alow2004/Archimedes_RPI_DoublePort_RAM_Podule/Board_Picture1.jpg

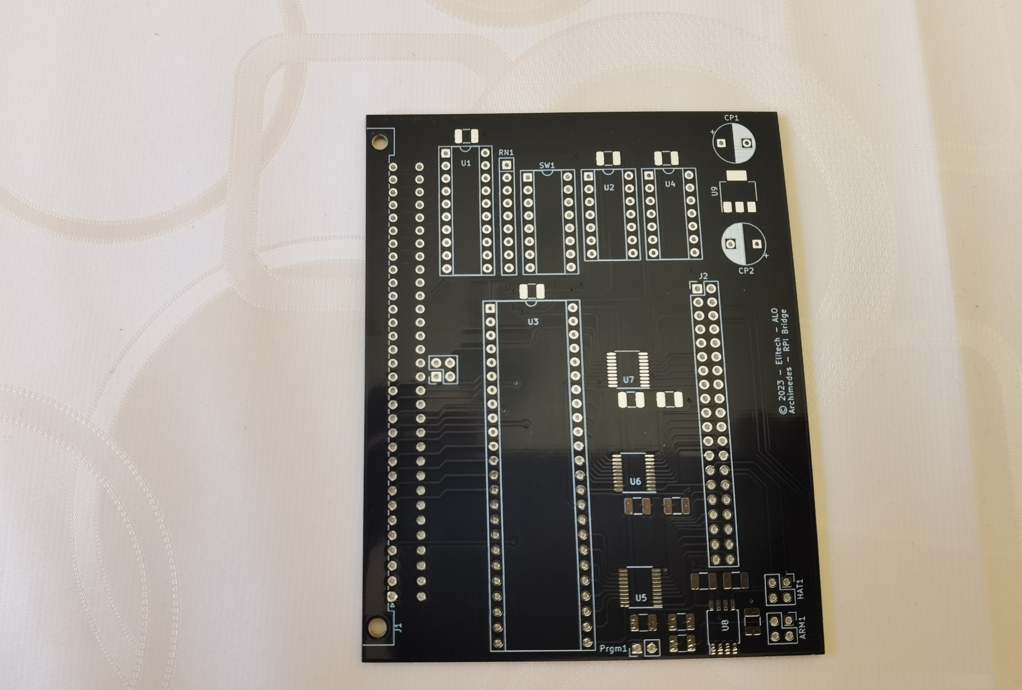
Board_Picture1.jpg
