alow2004/Archimedes_RPI_DoublePort_RAM_Podule/README.md

# Archimedes_RPI_DoublePort_RAM_Podule

Author: Alain.Lowet

First commit date: 20/09/2023

Subjects: Creation of an Acorn Archimedes podule to communicate with a Raspberry pi via an IDT double port RAM
