alow2004/Archimedes_RPI_DoublePort_RAM_Podule/7130_BRIDGE_Pictures/IMG_20231025_115119_resized_20231025_115321708.jpg

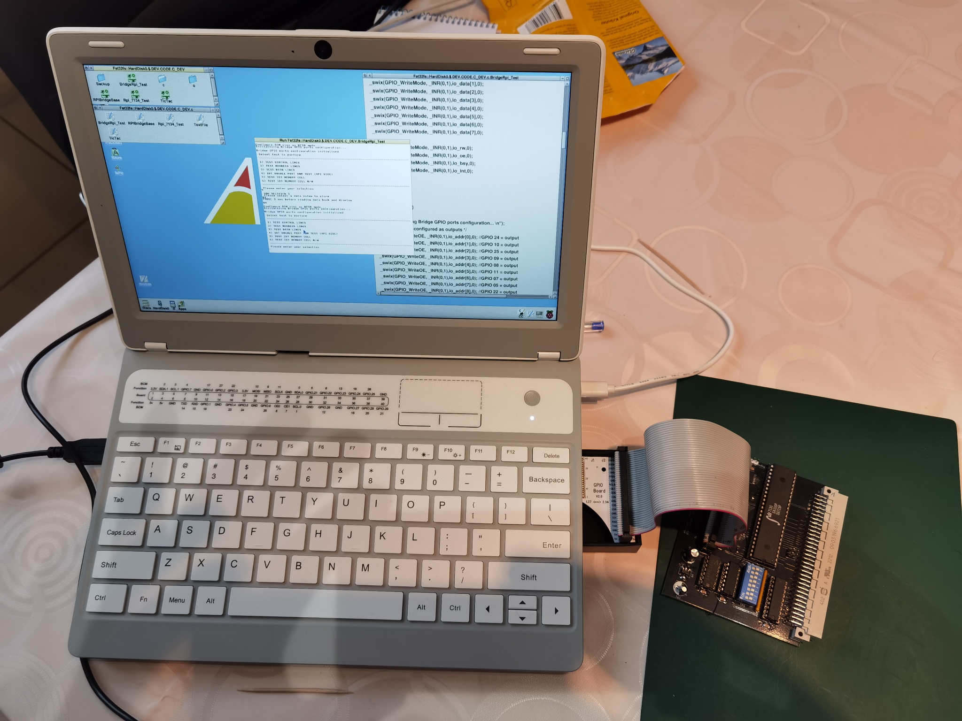
7130_BRIDGE_Pictures/IMG_20231025_115119_resized_20231025_115321708.jpg
