alow2004/Archimedes_RPI_DoublePort_RAM_Podule/7130_BRIDGE_Pictures/IMG_20231025_115132_resized_20231025_115321154.jpg

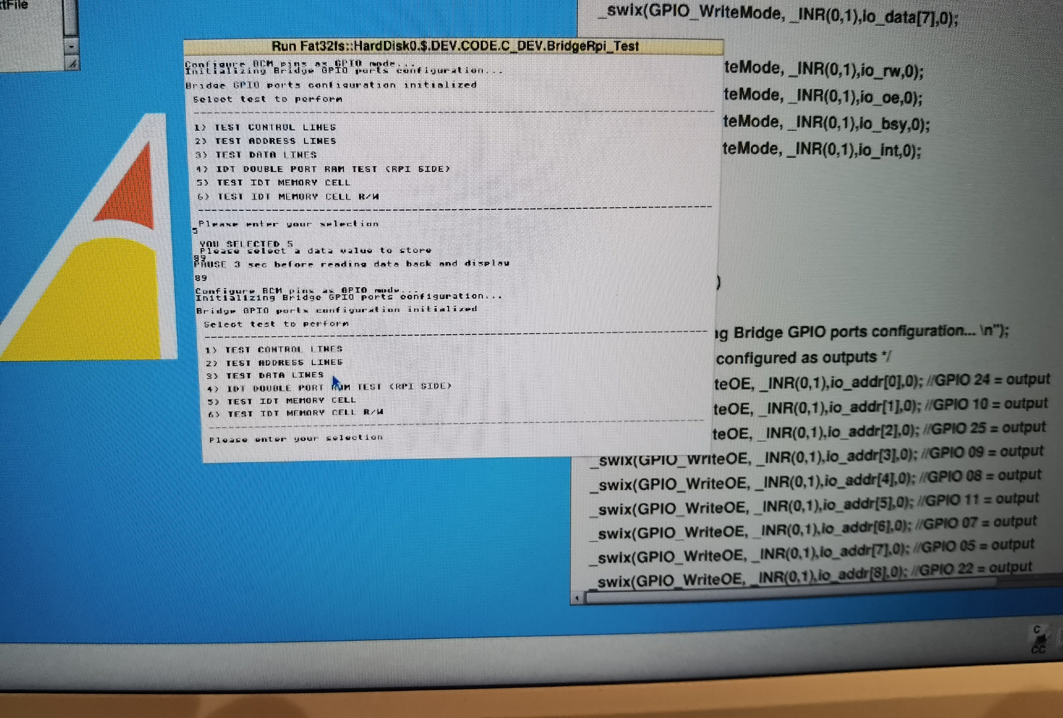
7130_BRIDGE_Pictures/IMG_20231025_115132_resized_20231025_115321154.jpg
