alow2004/Archimedes_RPI_DoublePort_RAM_Podule/7130_BRIDGE_Pictures/IMG_20231025_115139_resized_20231025_115322183.jpg

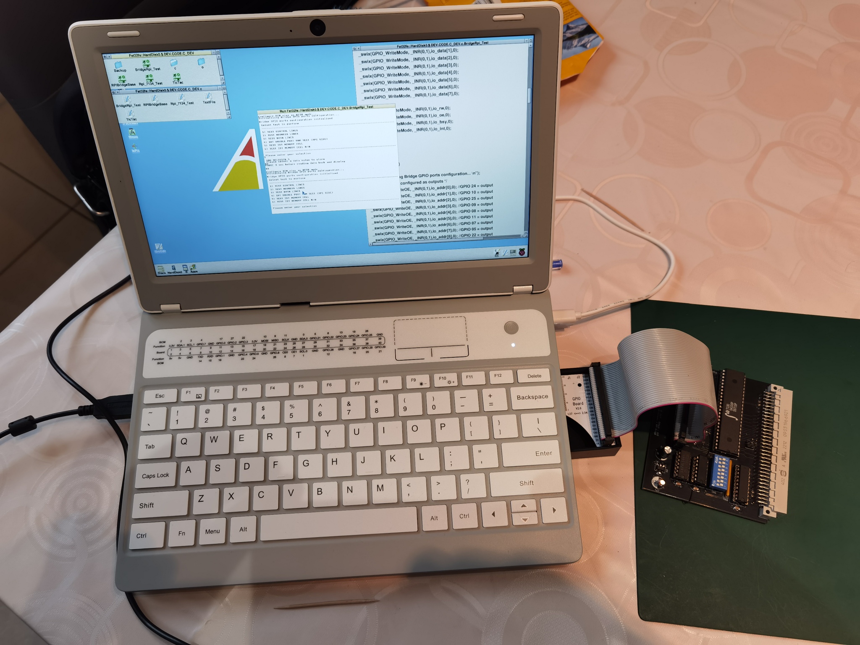
7130_BRIDGE_Pictures/IMG_20231025_115139_resized_20231025_115322183.jpg
