alow2004/Archimedes_RPI_DoublePort_RAM_Podule/7134_BRIDGE/BoardPic6.jpg

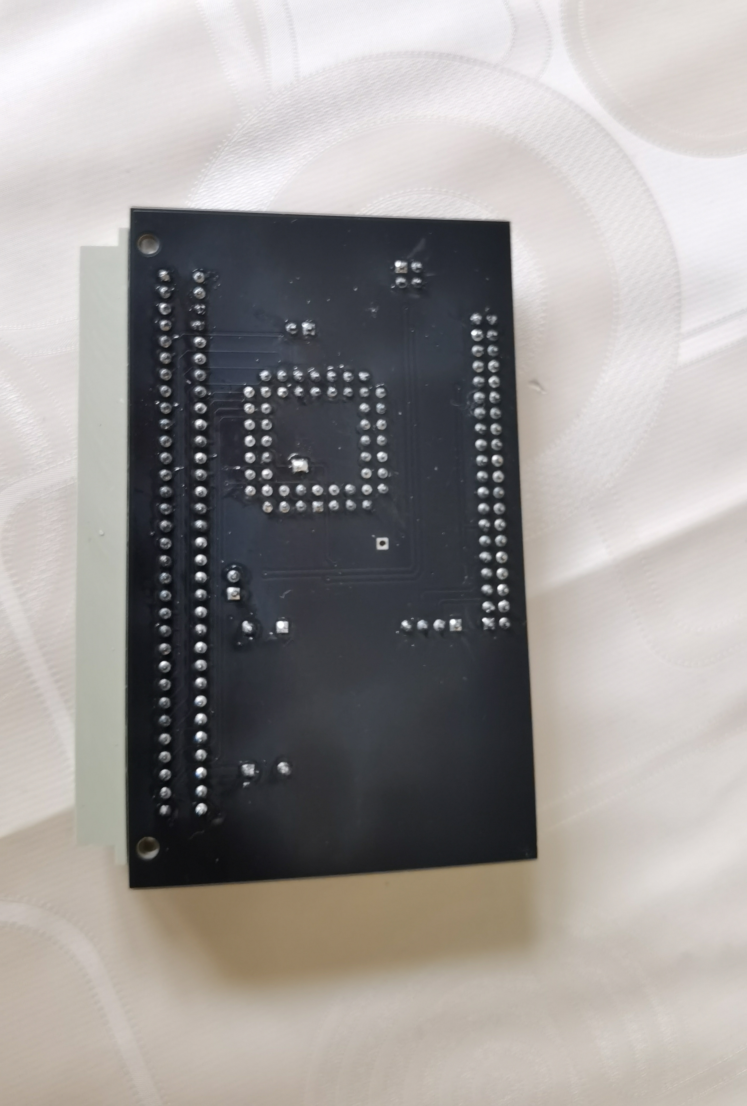
7134_BRIDGE/BoardPic6.jpg
