alow2004/Archimedes_RPI_DoublePort_RAM_Podule/7134_BRIDGE/Kicad Files/PCB_TOP.png

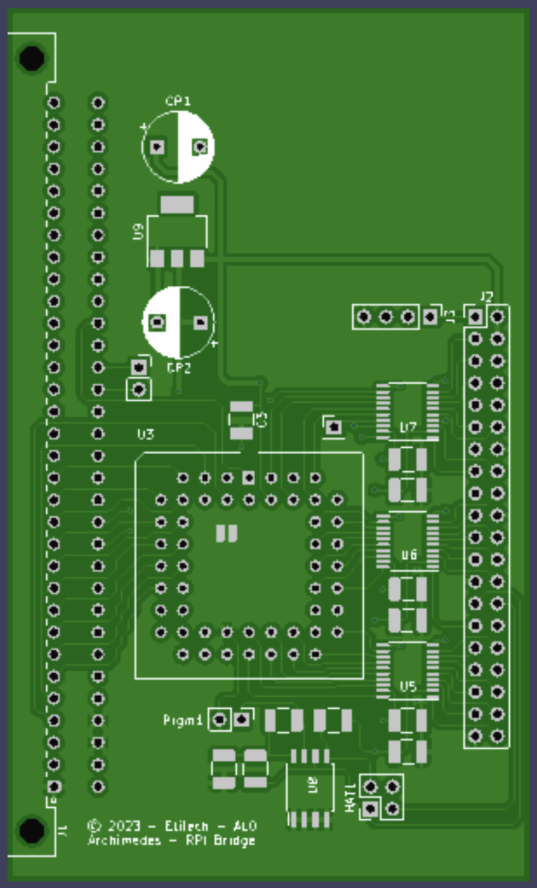
7134_BRIDGE/Kicad Files/PCB_TOP.png
