alow2004/Archimedes_RPI_DoublePort_RAM_Podule/PCB_BOTTOM.png

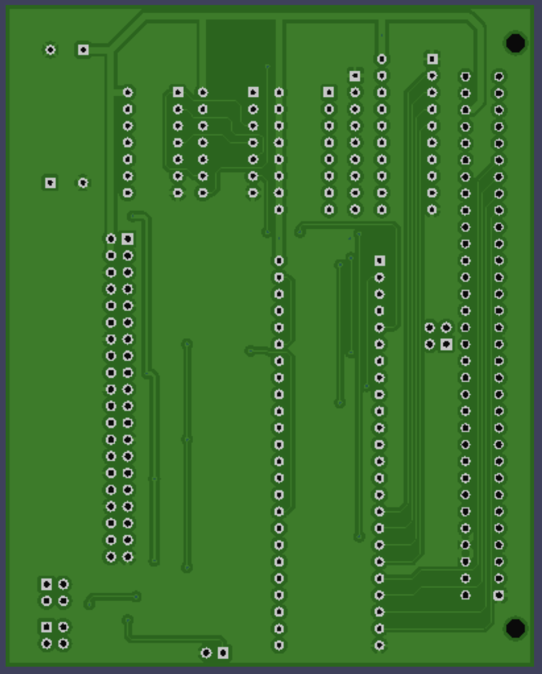
PCB_BOTTOM.png
