alow2004/Archimedes_RPI_DoublePort_RAM_Podule/PCB_TOP.png

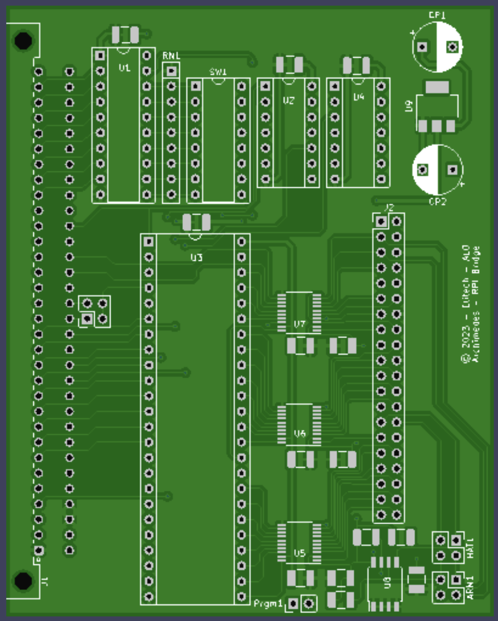
PCB_TOP.png
