alow2004/Archimedes_RPI_DoublePort_RAM_Podule/Podule_Schematics_1.0.png

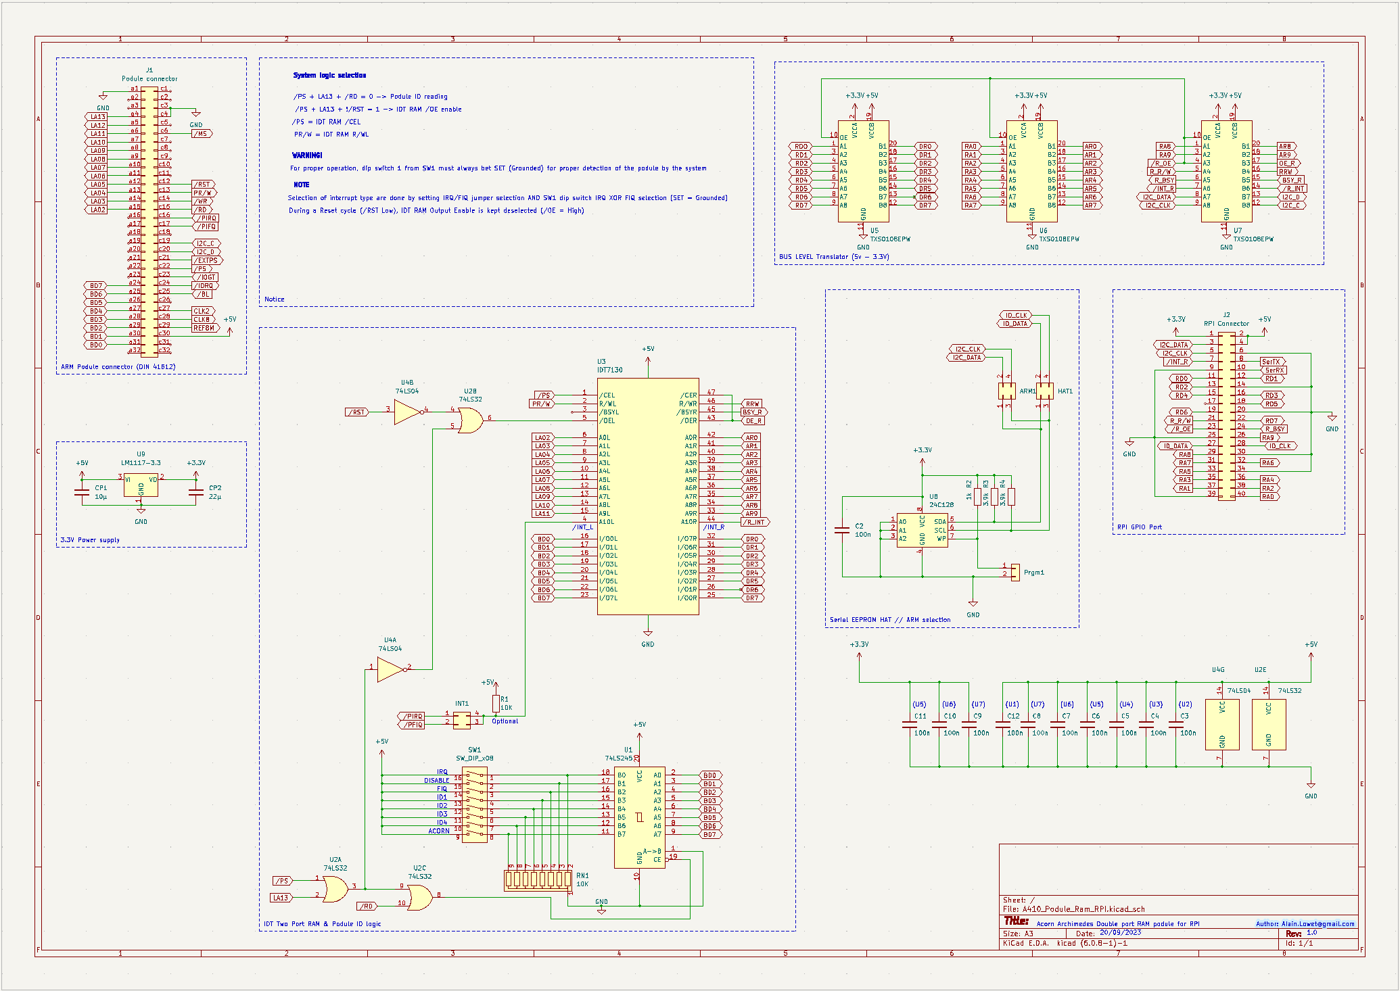
Podule_Schematics_1.0.png
