alow2004/Archimedes_RPI_DoublePort_RAM_Podule/Schematics_1.1.pdf

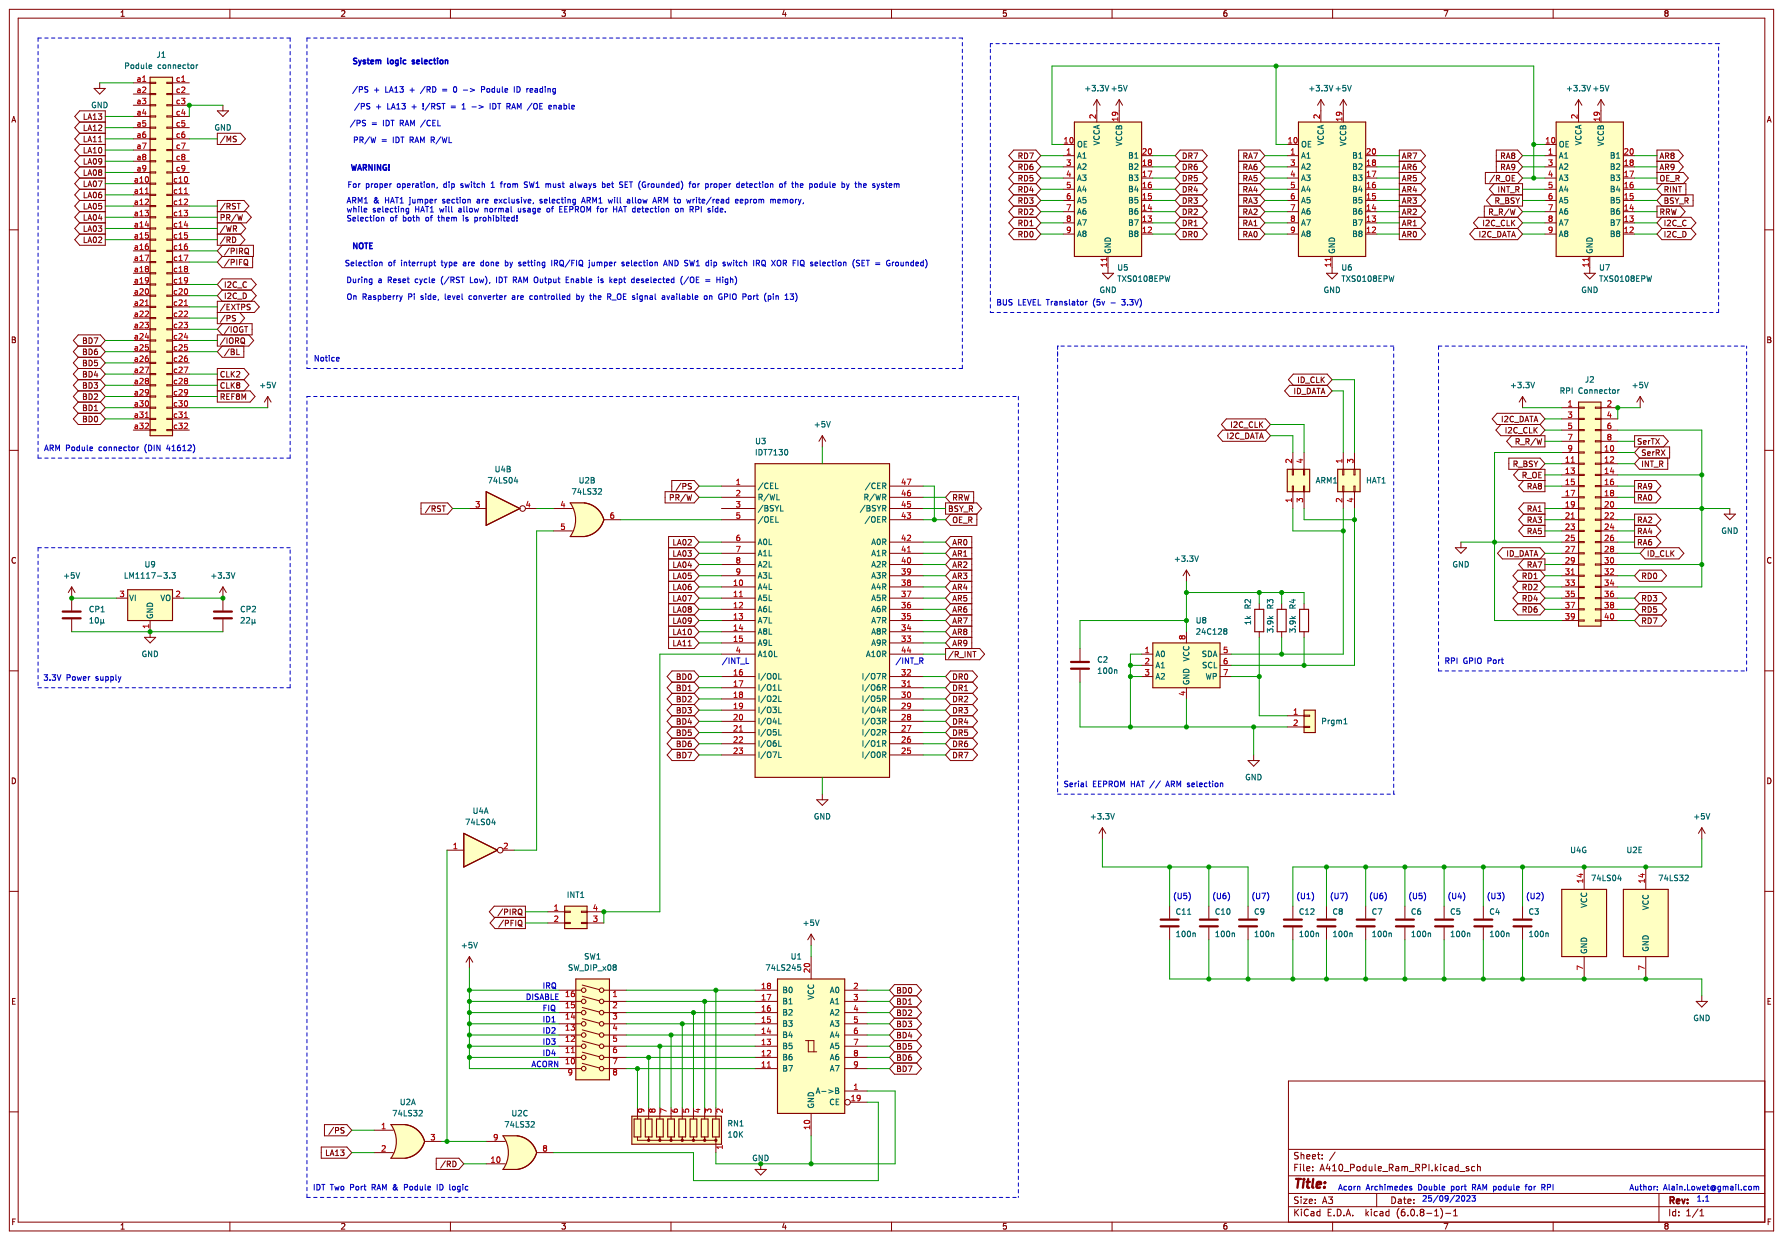
[picture p21: page 1]
