alow2004/Archimedes_RPI_DoublePort_RAM_Podule/Bottom_PCB.pdf

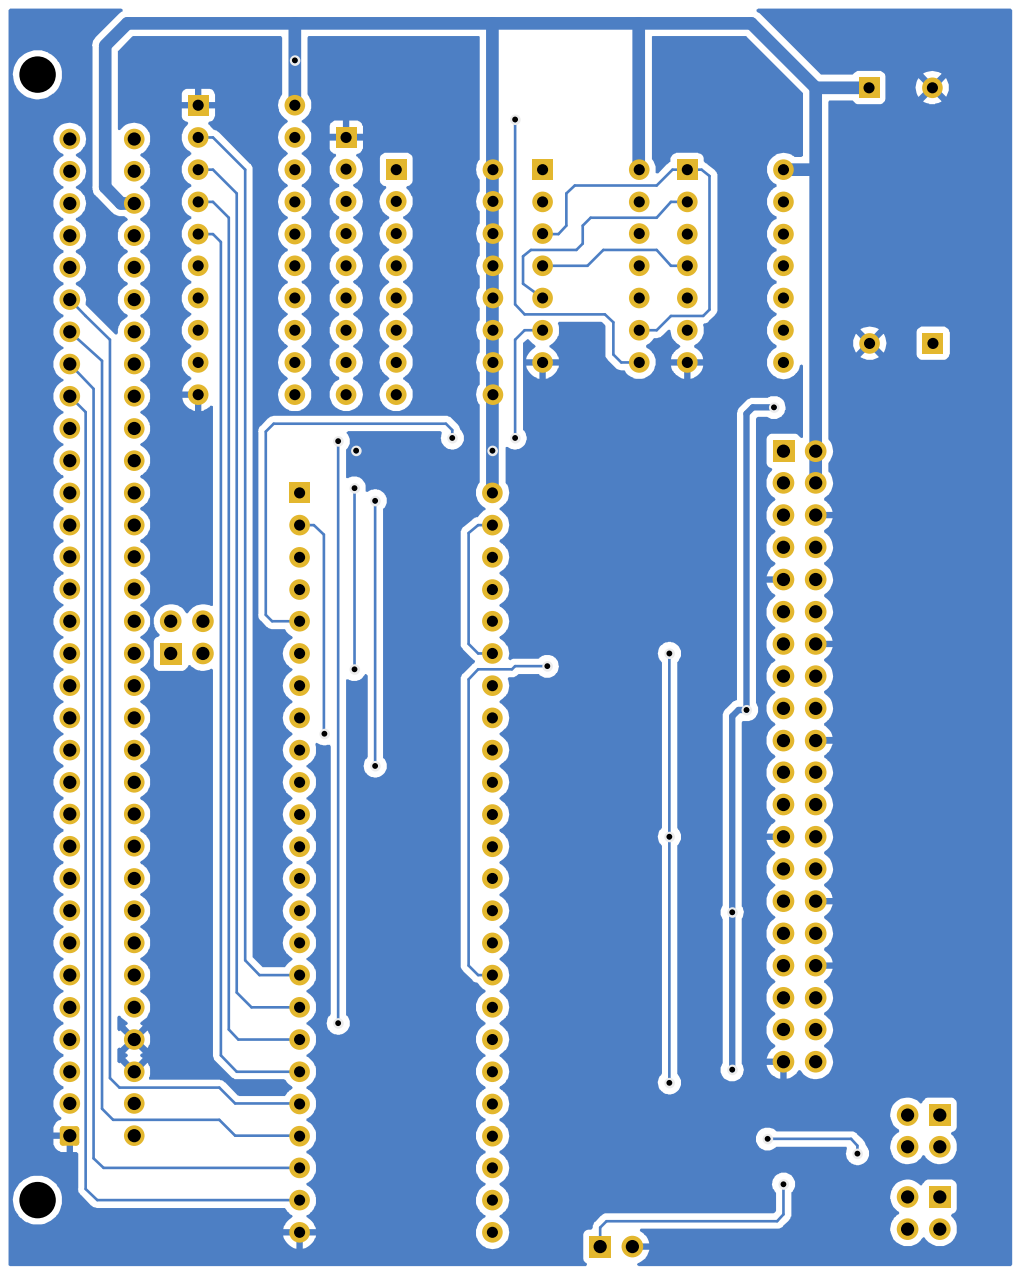
[picture p22: page 1]
