alow2004/Archimedes_RPI_DoublePort_RAM_Podule/Placement_PCB.pdf

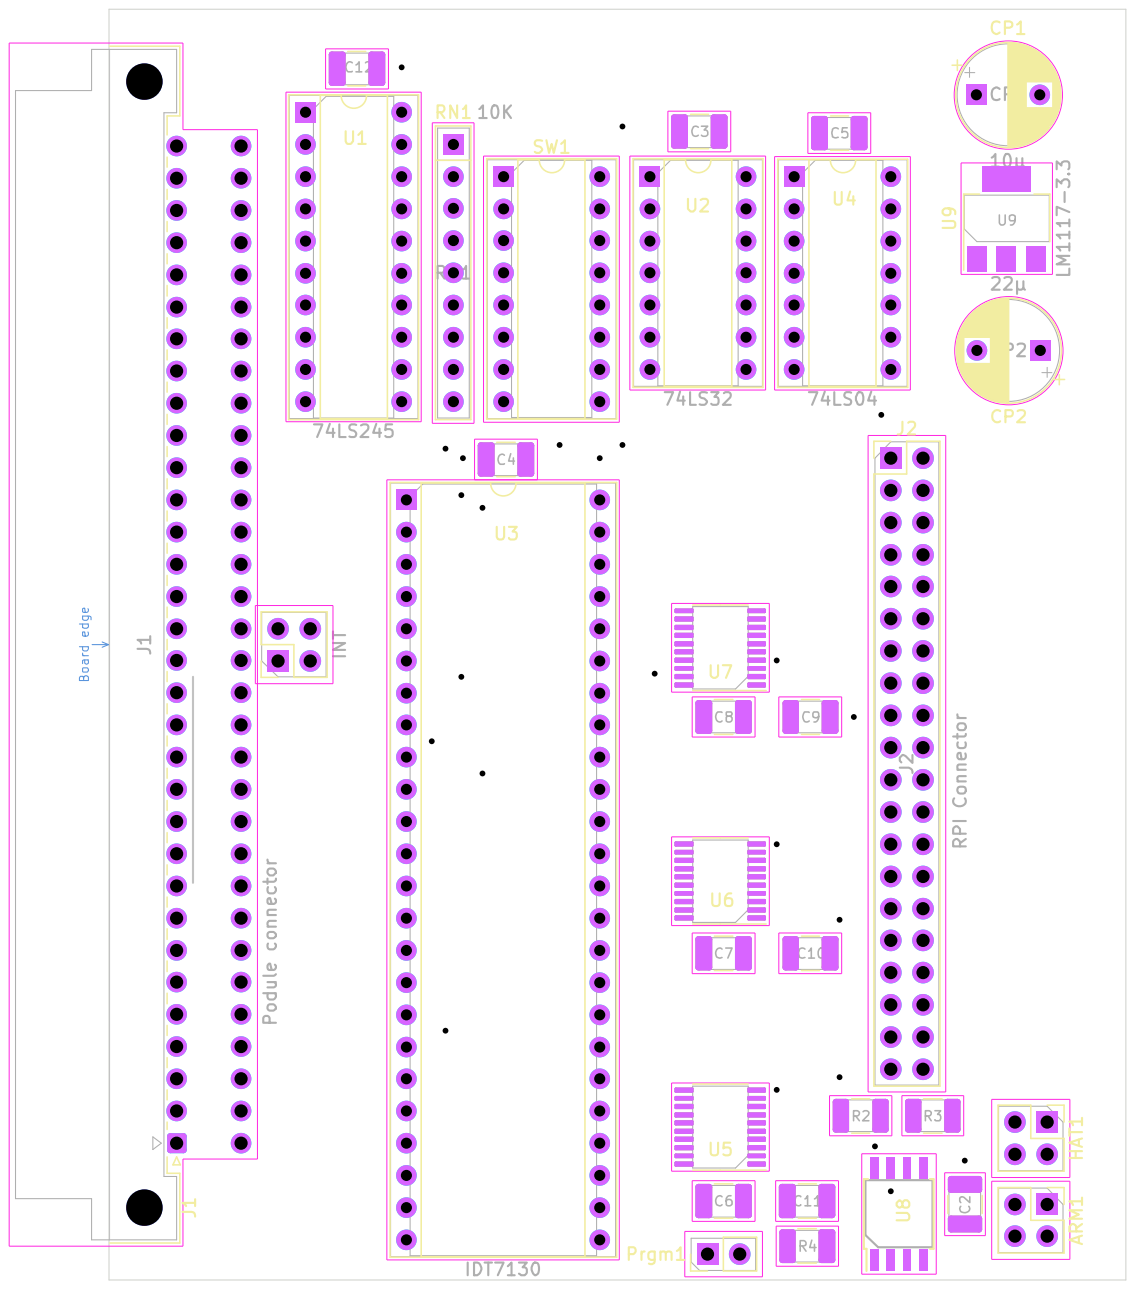
[picture p23: page 1]
