alow2004/Archimedes_RPI_DoublePort_RAM_Podule/Top_PCB.pdf

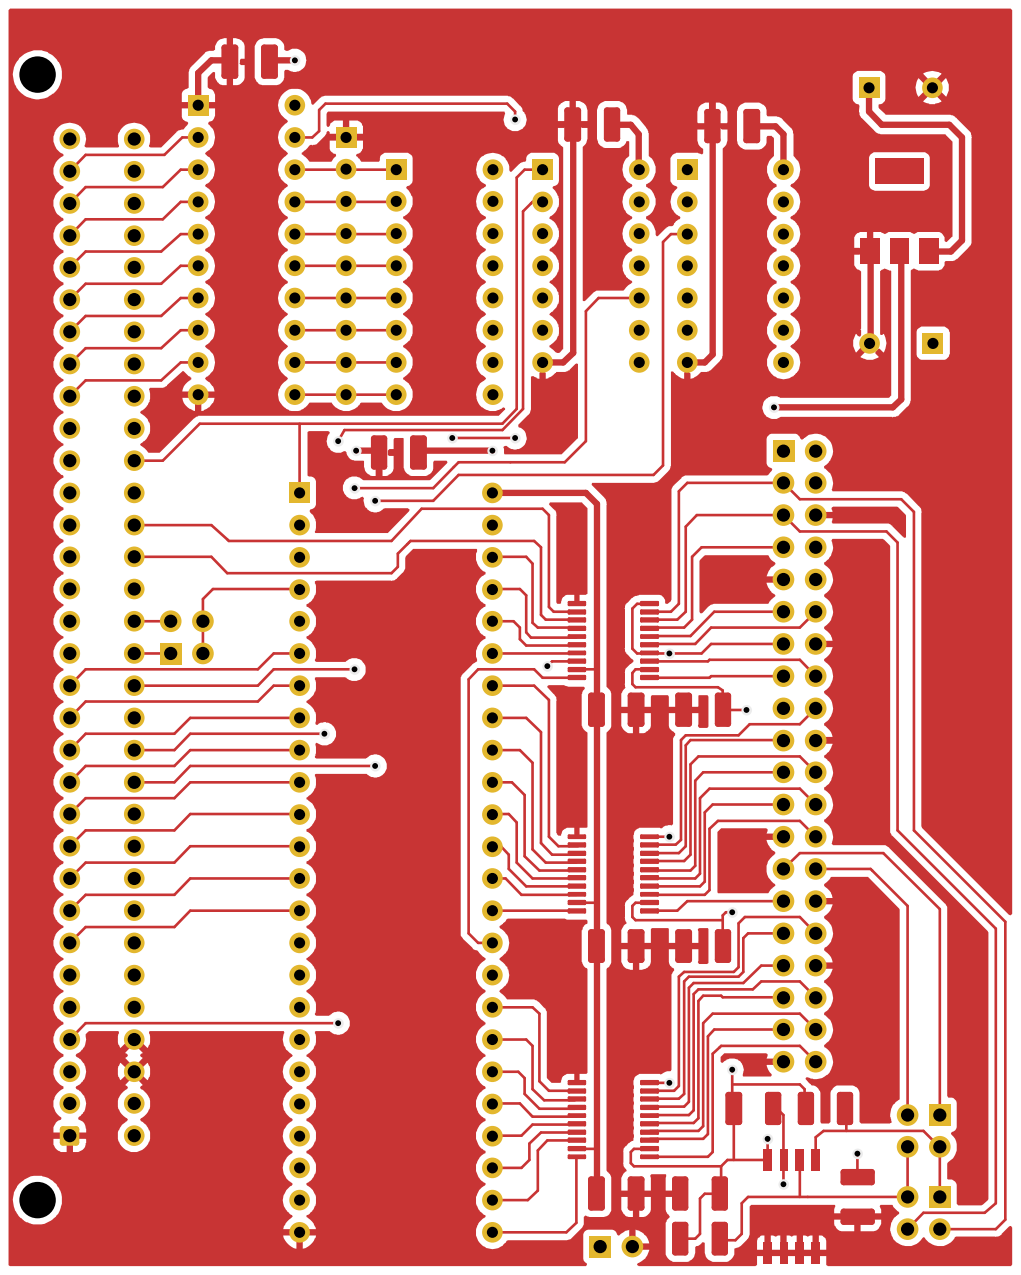
[picture p24: page 1]
