alow2004/Archimedes_RPI_DoublePort_RAM_Podule/7134_BRIDGE/Kicad Files/A410_Bridge_7134.pdf

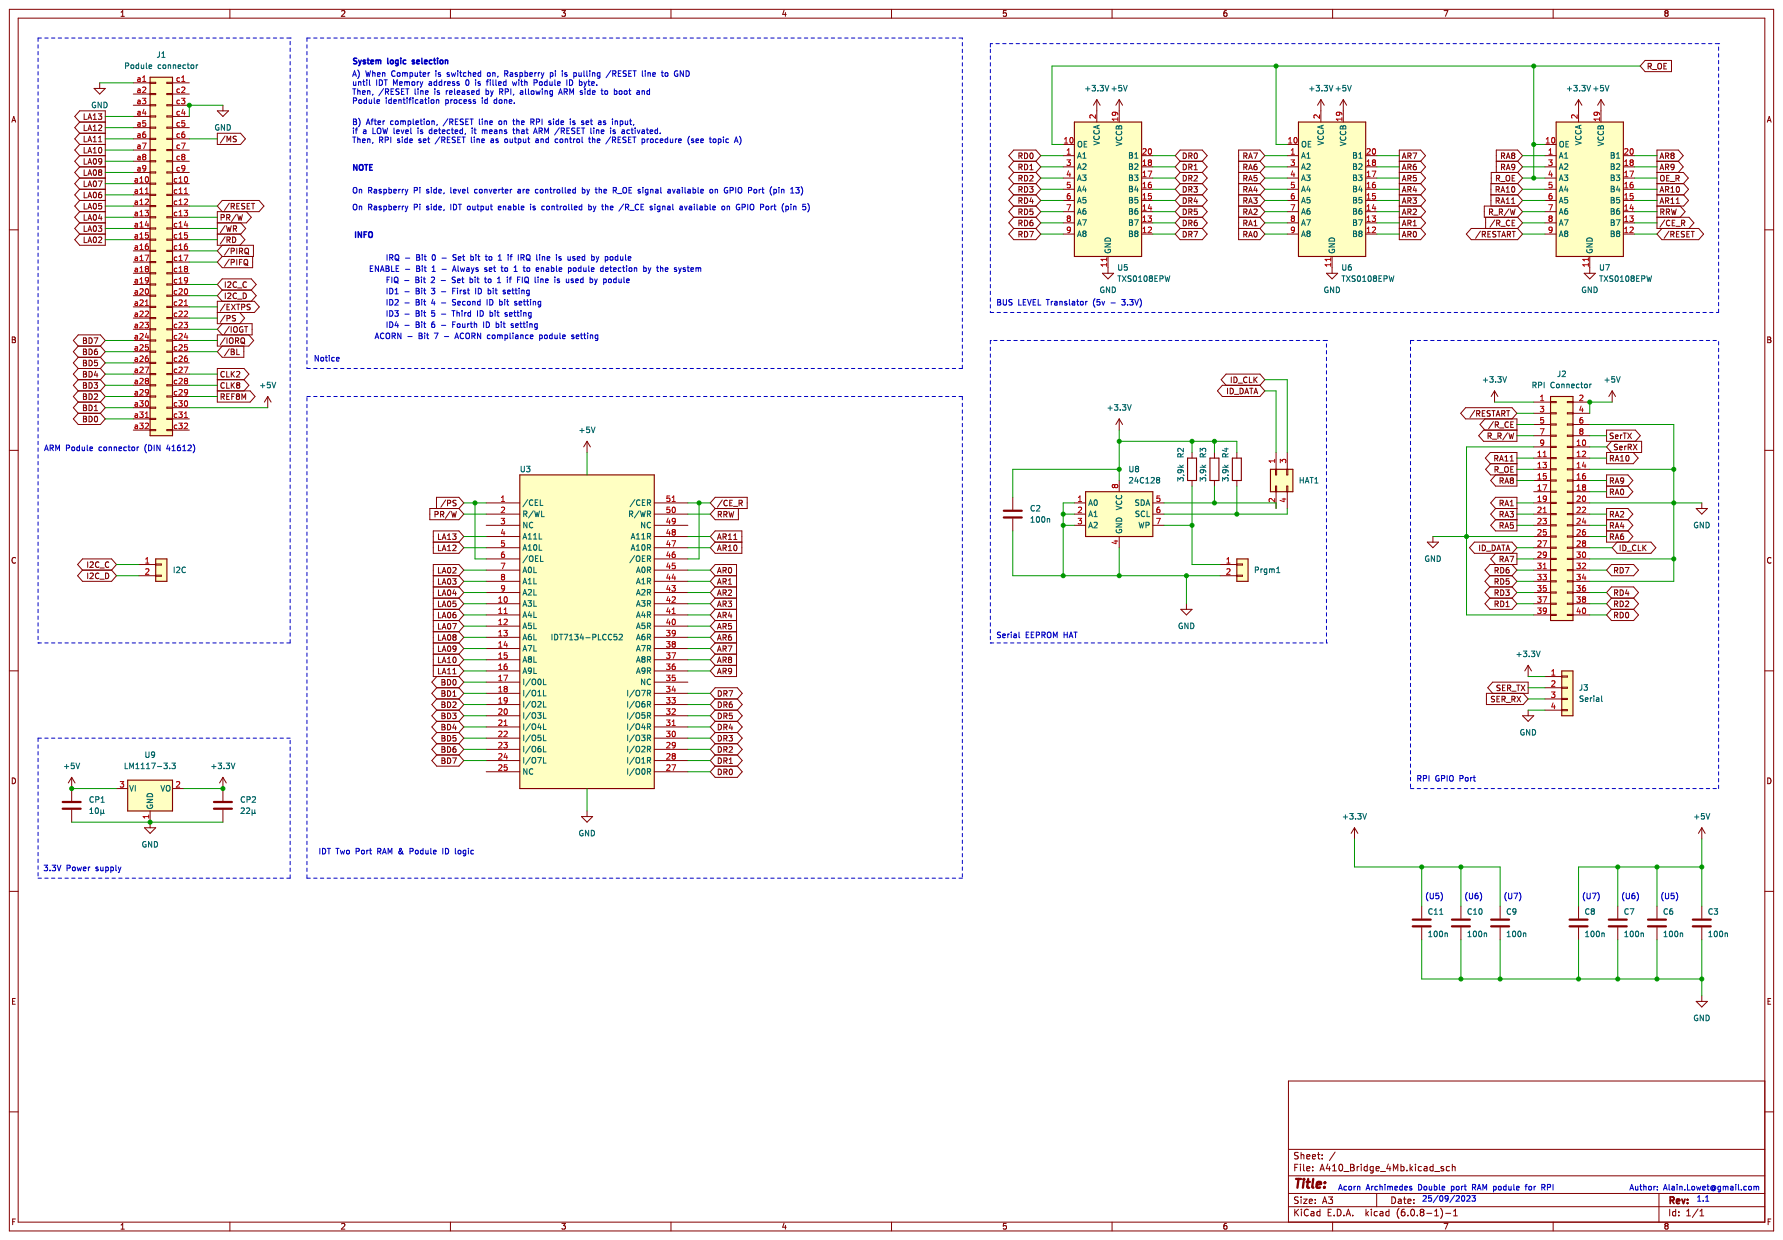
[picture p25: page 1]
