alow2004/Archimedes_RPI_DoublePort_RAM_Podule/7134_BRIDGE/Kicad Files/A410_Bridge_7134.kicad_pcb

## KiCad design 7134_BRIDGE/Kicad Files/A410_Bridge_7134.kicad_pcb (2023-10-23)

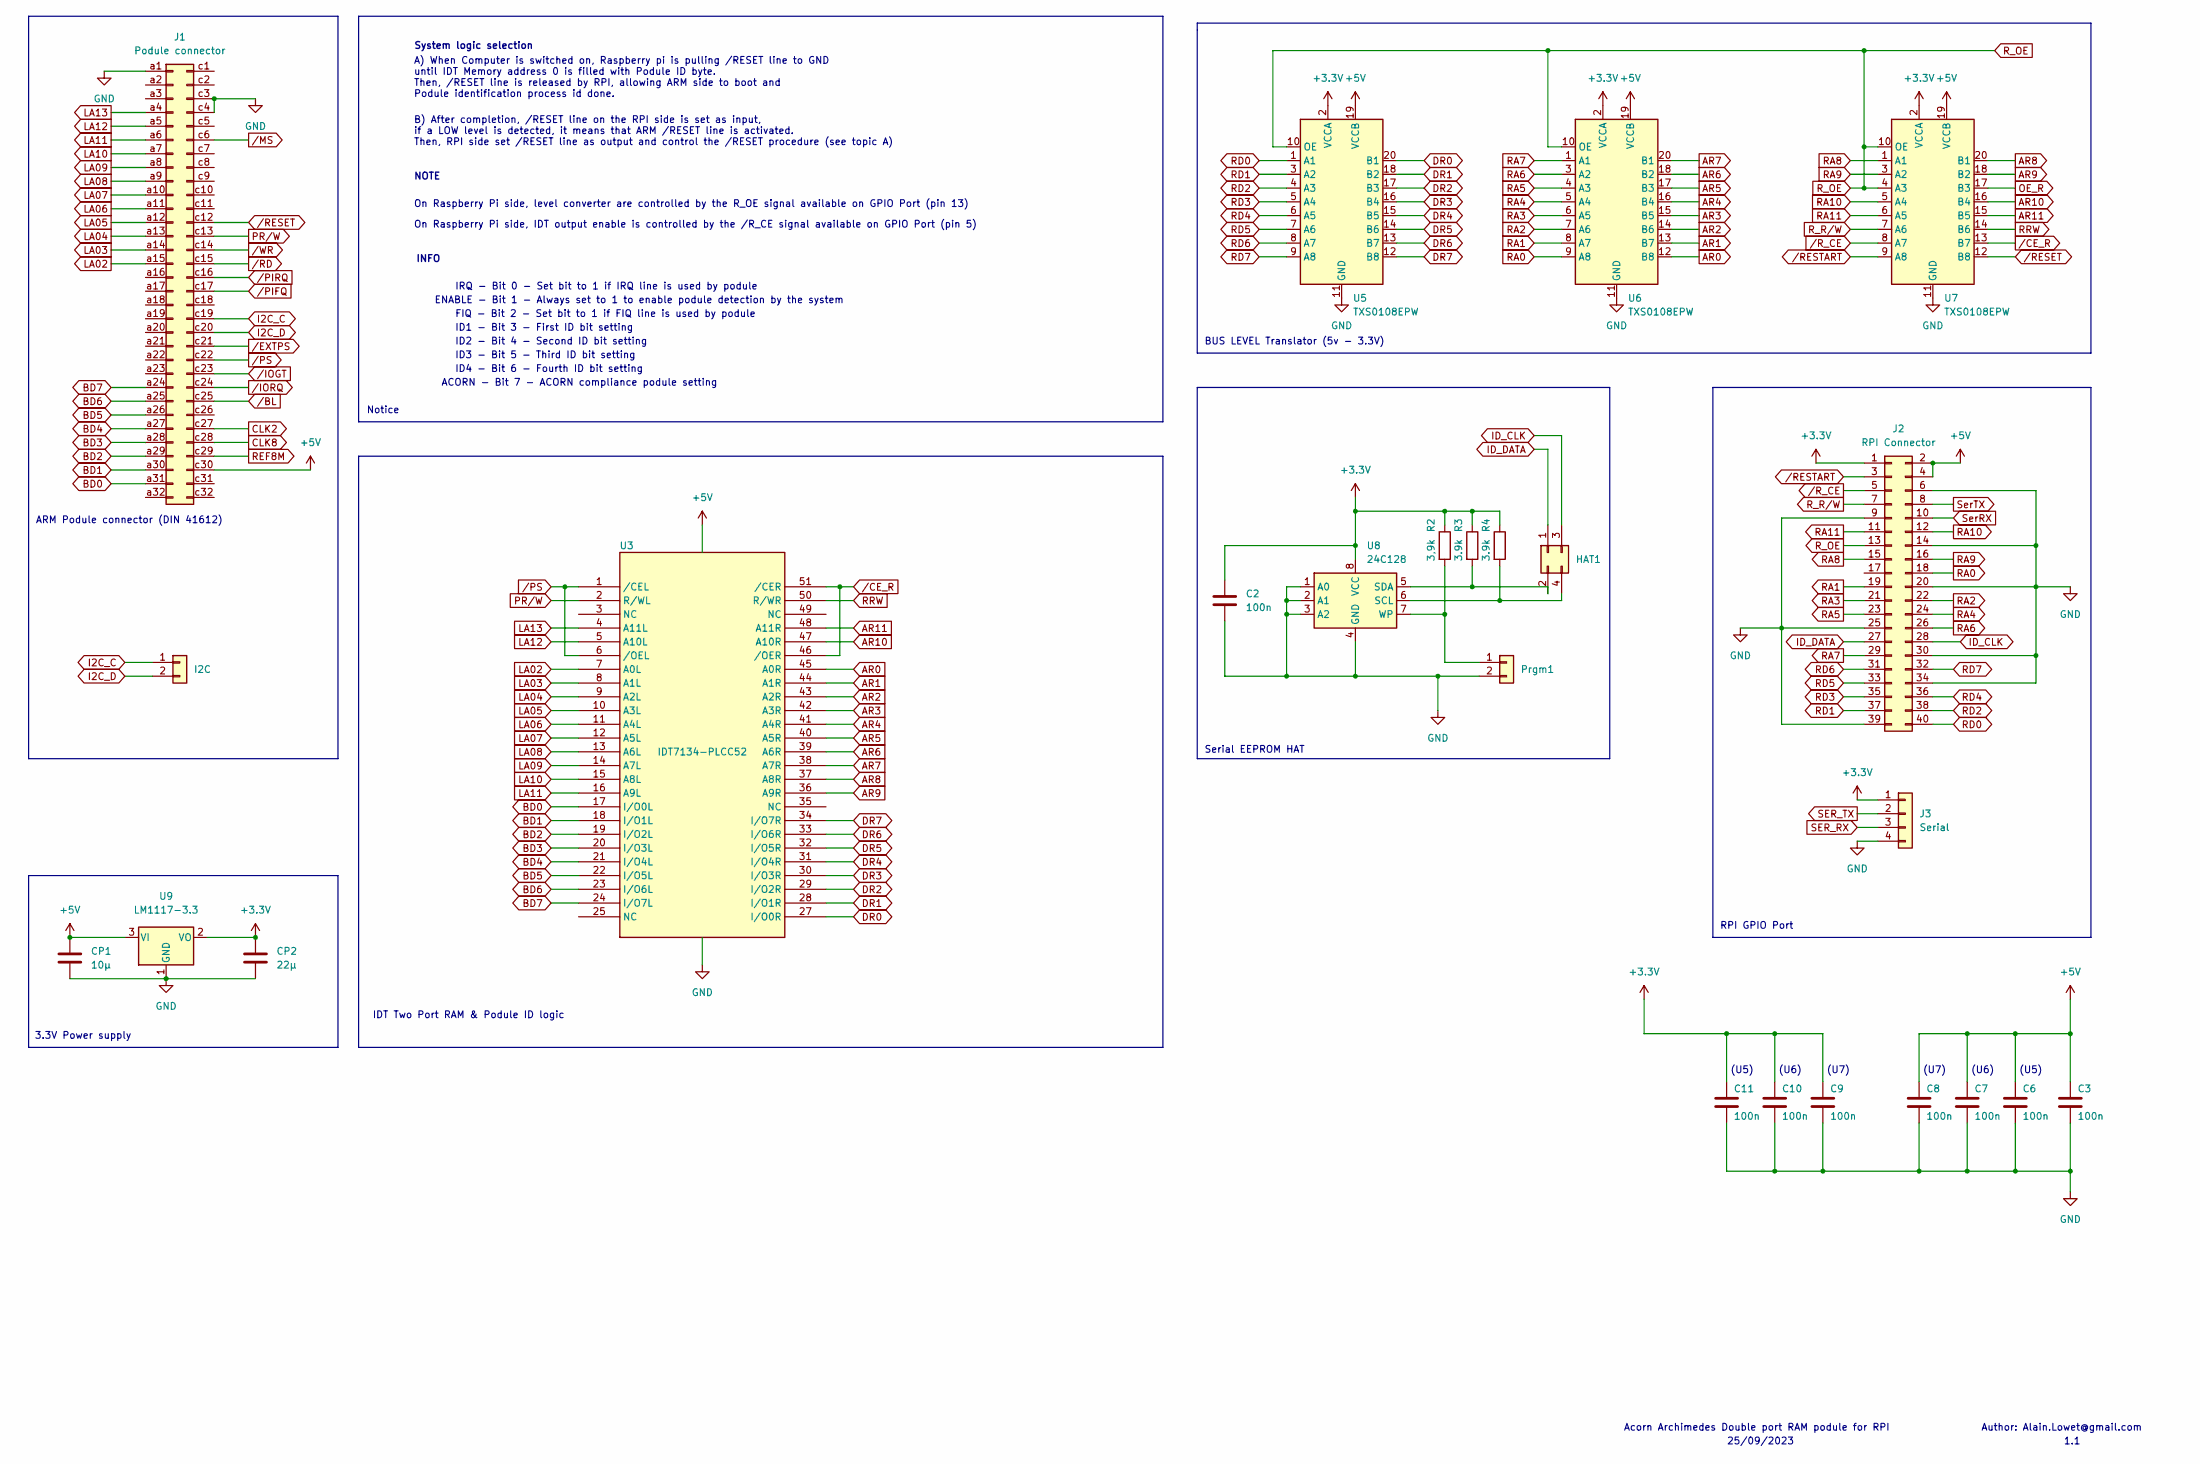
[picture p26: schematic A410_Bridge_7134.kicad_sch]

Parts:
C2, C3, C6, C7, C8, C9, C10, C11: 100n; C_1210_3225Metric_Pad1.33x2.70mm_HandSolder
CP1: 10µ; CP_Radial_D8.0mm_P5.00mm
CP2: 22µ; CP_Radial_D8.0mm_P5.00mm
HAT1: Conn_02x02_Odd_Even; PinHeader_2x02_P2.54mm_Vertical
I2C: Prgm; PinHeader_1x02_P2.54mm_Vertical
J1: Podule connector; DIN41612_R_2x32_Male_Horizontal_THT
J2: RPI Connector; PinHeader_2x20_P2.54mm_Vertical
J3: Serial; PinHeader_1x04_P2.54mm_Vertical
Prgm1: Prgm; PinHeader_1x02_P2.54mm_Vertical
R2: 3,9k; R_1210_3225Metric_Pad1.30x2.65mm_HandSolder
R3, R4: 3.9k; R_1210_3225Metric_Pad1.30x2.65mm_HandSolder
U3: IDT7134-PLCC52; PLCC-52_THT-Socket
U5, U6, U7: TXS0108EPW; TSSOP-20_4.4x6.5mm_P0.65mm
U8: 24C128; SOIC-8W_5.3x5.3mm_P1.27mm
U9: LM1117-3.3; SOT-223-3_TabPin2

Connections:
+3.3V: C2.1, C9.1, C10.1, C11.1, CP2.1, J2.1, J3.1, R2.1, R3.1, R4.1, U5.2 (VCCA), U6.2 (VCCA), U7.2 (VCCA), U8.8 (VCC), U9.2 (VO)
+5V: C3.1, C6.1, C7.1, C8.1, CP1.1, J1.c30, J2.2, J2.4, U3.52 (VCC), U5.19 (VCCB), U6.19 (VCCB), U7.19 (VCCB), U9.3 (VI)
AR0: U3.45 (A0R), U6.12 (B8)
AR1: U3.44 (A1R), U6.13 (B7)
AR2: U3.43 (A2R), U6.14 (B6)
AR3: U3.42 (A3R), U6.15 (B5)
AR4: U3.41 (A4R), U6.16 (B4)
AR5: U3.40 (A5R), U6.17 (B3)
AR6: U3.39 (A6R), U6.18 (B2)
AR7: U3.38 (A7R), U6.20 (B1)
AR8: U3.37 (A8R), U7.20 (B1)
AR9: U3.36 (A9R), U7.18 (B2)
AR10: U3.47 (A10R), U7.16 (B4)
AR11: U3.48 (A11R), U7.15 (B5)
BD0: J1.a31, U3.17 (I/O0L)
BD1: J1.a30, U3.18 (I/O1L)
BD2: J1.a29, U3.19 (I/O2L)
BD3: J1.a28, U3.20 (I/O3L)
BD4: J1.a27, U3.21 (I/O4L)
BD5: J1.a26, U3.22 (I/O5L)
BD6: J1.a25, U3.23 (I/O6L)
BD7: J1.a24, U3.24 (I/O7L)
CLK2: J1.c27
CLK8: J1.c28
DR0: U3.27 (I/O0R), U5.20 (B1)
DR1: U3.28 (I/O1R), U5.18 (B2)
DR2: U3.29 (I/O2R), U5.17 (B3)
DR3: U3.30 (I/O3R), U5.16 (B4)
DR4: U3.31 (I/O4R), U5.15 (B5)
DR5: U3.32 (I/O5R), U5.14 (B6)
DR6: U3.33 (I/O6R), U5.13 (B7)
DR7: U3.34 (I/O7R), U5.12 (B8)
GND: C2.2, C3.2, C6.2, C7.2, C8.2, C9.2, C10.2, C11.2, CP1.2, CP2.2, J1.a1, J1.c3, J1.c4, J2.6, J2.9, J2.14, J2.20, J2.25, J2.30, J2.34, J2.39, J3.4, Prgm1.2, U3.26 (GND), U5.11 (GND), U6.11 (GND), U7.11 (GND), U8.1 (A0), U8.2 (A1), U8.3 (A2), U8.4 (GND), U9.1 (GND)
I2C_C: I2C.1, J1.c19
I2C_D: I2C.2, J1.c20
ID_CLK: HAT1.3, J2.28
ID_DATA: HAT1.1, J2.27
LA02: J1.a15, U3.7 (A0L)
LA03: J1.a14, U3.8 (A1L)
LA04: J1.a13, U3.9 (A2L)
LA05: J1.a12, U3.10 (A3L)
LA06: J1.a11, U3.11 (A4L)
LA07: J1.a10, U3.12 (A5L)
LA08: J1.a9, U3.13 (A6L)
LA09: J1.a8, U3.14 (A7L)
LA10: J1.a7, U3.15 (A8L)
LA11: J1.a6, U3.16 (A9L)
LA12: J1.a5, U3.5 (A10L)
LA13: J1.a4, U3.4 (A11L)
unnamed: HAT1.2, R3.2, U8.5 (SDA)
unnamed: HAT1.4, R4.2, U8.6 (SCL)
unnamed: Prgm1.1, R2.2, U8.7 (WP)
OE_R: U7.17 (B3)
PR/W: J1.c13, U3.2 (R/WL)
RA0: J2.18, U6.9 (A8)
RA1: J2.19, U6.8 (A7)
RA2: J2.22, U6.7 (A6)
RA3: J2.21, U6.6 (A5)
RA4: J2.24, U6.5 (A4)
RA5: J2.23, U6.4 (A3)
RA6: J2.26, U6.3 (A2)
RA7: J2.29, U6.1 (A1)
RA8: J2.15, U7.1 (A1)
RA9: J2.16, U7.3 (A2)
RA10: J2.12, U7.5 (A4)
RA11: J2.11, U7.6 (A5)
RD0: J2.40, U5.1 (A1)
RD1: J2.37, U5.3 (A2)
RD2: J2.38, U5.4 (A3)
RD3: J2.35, U5.5 (A4)
RD4: J2.36, U5.6 (A5)
RD5: J2.33, U5.7 (A6)
RD6: J2.31, U5.8 (A7)
RD7: J2.32, U5.9 (A8)
REF8M: J1.c29
RRW: U3.50 (R/WR), U7.14 (B6)
R_OE: J2.13, U5.10 (OE), U6.10 (OE), U7.4 (A3), U7.10 (OE)
R_R/W: J2.7, U7.7 (A6)
SER_RX: J3.3
SER_TX: J3.2
SerRX: J2.10
SerTX: J2.8
/BL: J1.c25
/CE_R: U3.46 (/OER), U3.51 (/CER), U7.13 (B7)
/EXTPS: J1.c21
/IOGT: J1.c23
/IORQ: J1.c24
/MS: J1.c6
/PIFQ: J1.c17
/PIRQ: J1.c16
/PS: J1.c22, U3.1 (/CEL), U3.6 (/OEL)
/RD: J1.c15
/RESET: J1.c12, U7.12 (B8)
/RESTART: J2.3, U7.9 (A8)
/R_CE: J2.5, U7.8 (A7)
/WR: J1.c14

Notes on the sheet:
(U5)
ID4 - Bit 6 - Fourth ID bit setting
RPI GPIO Port
ARM Podule connector (DIN 41612)
System logic selection
On Raspberry Pi side, IDT output enable is controlled by the /R_CE signal available on GPIO Port (pin 5)
ID3 - Bit 5 - Third ID bit setting
ENABLE - Bit 1 - Always set to 1 to enable podule detection by the system
NOTE
(U7)
ID1 - Bit 3 - First ID bit setting
Acorn Archimedes Double port RAM podule for RPI
Notice
INFO
On Raspberry Pi side, level converter are controlled by the R_OE signal available on GPIO Port (pin 13)
3.3V Power supply
Serial EEPROM HAT
1.1
FIQ - Bit 2 - Set bit to 1 if FIQ line is used by podule
B) After completion, /RESET line on the RPI side is set as input, if a LOW level is detected, it means that ARM /RESET line is activated. Then, RPI side set /RESET line as output and control the /RESET procedure (see topic A)
(U6)
ACORN - Bit 7 - ACORN compliance podule setting
BUS LEVEL Translator (5v - 3.3V)
IDT Two Port RAM & Podule ID logic
A) When Computer is switched on, Raspberry pi is pulling /RESET line to GND until IDT Memory address 0 is filled with Podule ID byte. Then, /RESET line is released by RPI, allowing ARM side to boot and Podule identification process id done.
Author: Alain.Lowet@gmail.com
25/09/2023
IRQ - Bit 0 - Set bit to 1 if IRQ line is used by podule
ID2 - Bit 4 - Second ID bit setting

Board: 2 copper layers, 24 parts (0 on the bottom side), 77 nets, no tracks yet.
