alow2004/Archimedes_RPI_DoublePort_RAM_Podule/A410_Podule_Ram_RPI/A410_Podule_Ram_RPI.kicad_pcb

## KiCad design A410_Podule_Ram_RPI/A410_Podule_Ram_RPI.kicad_pcb (2023-09-30)

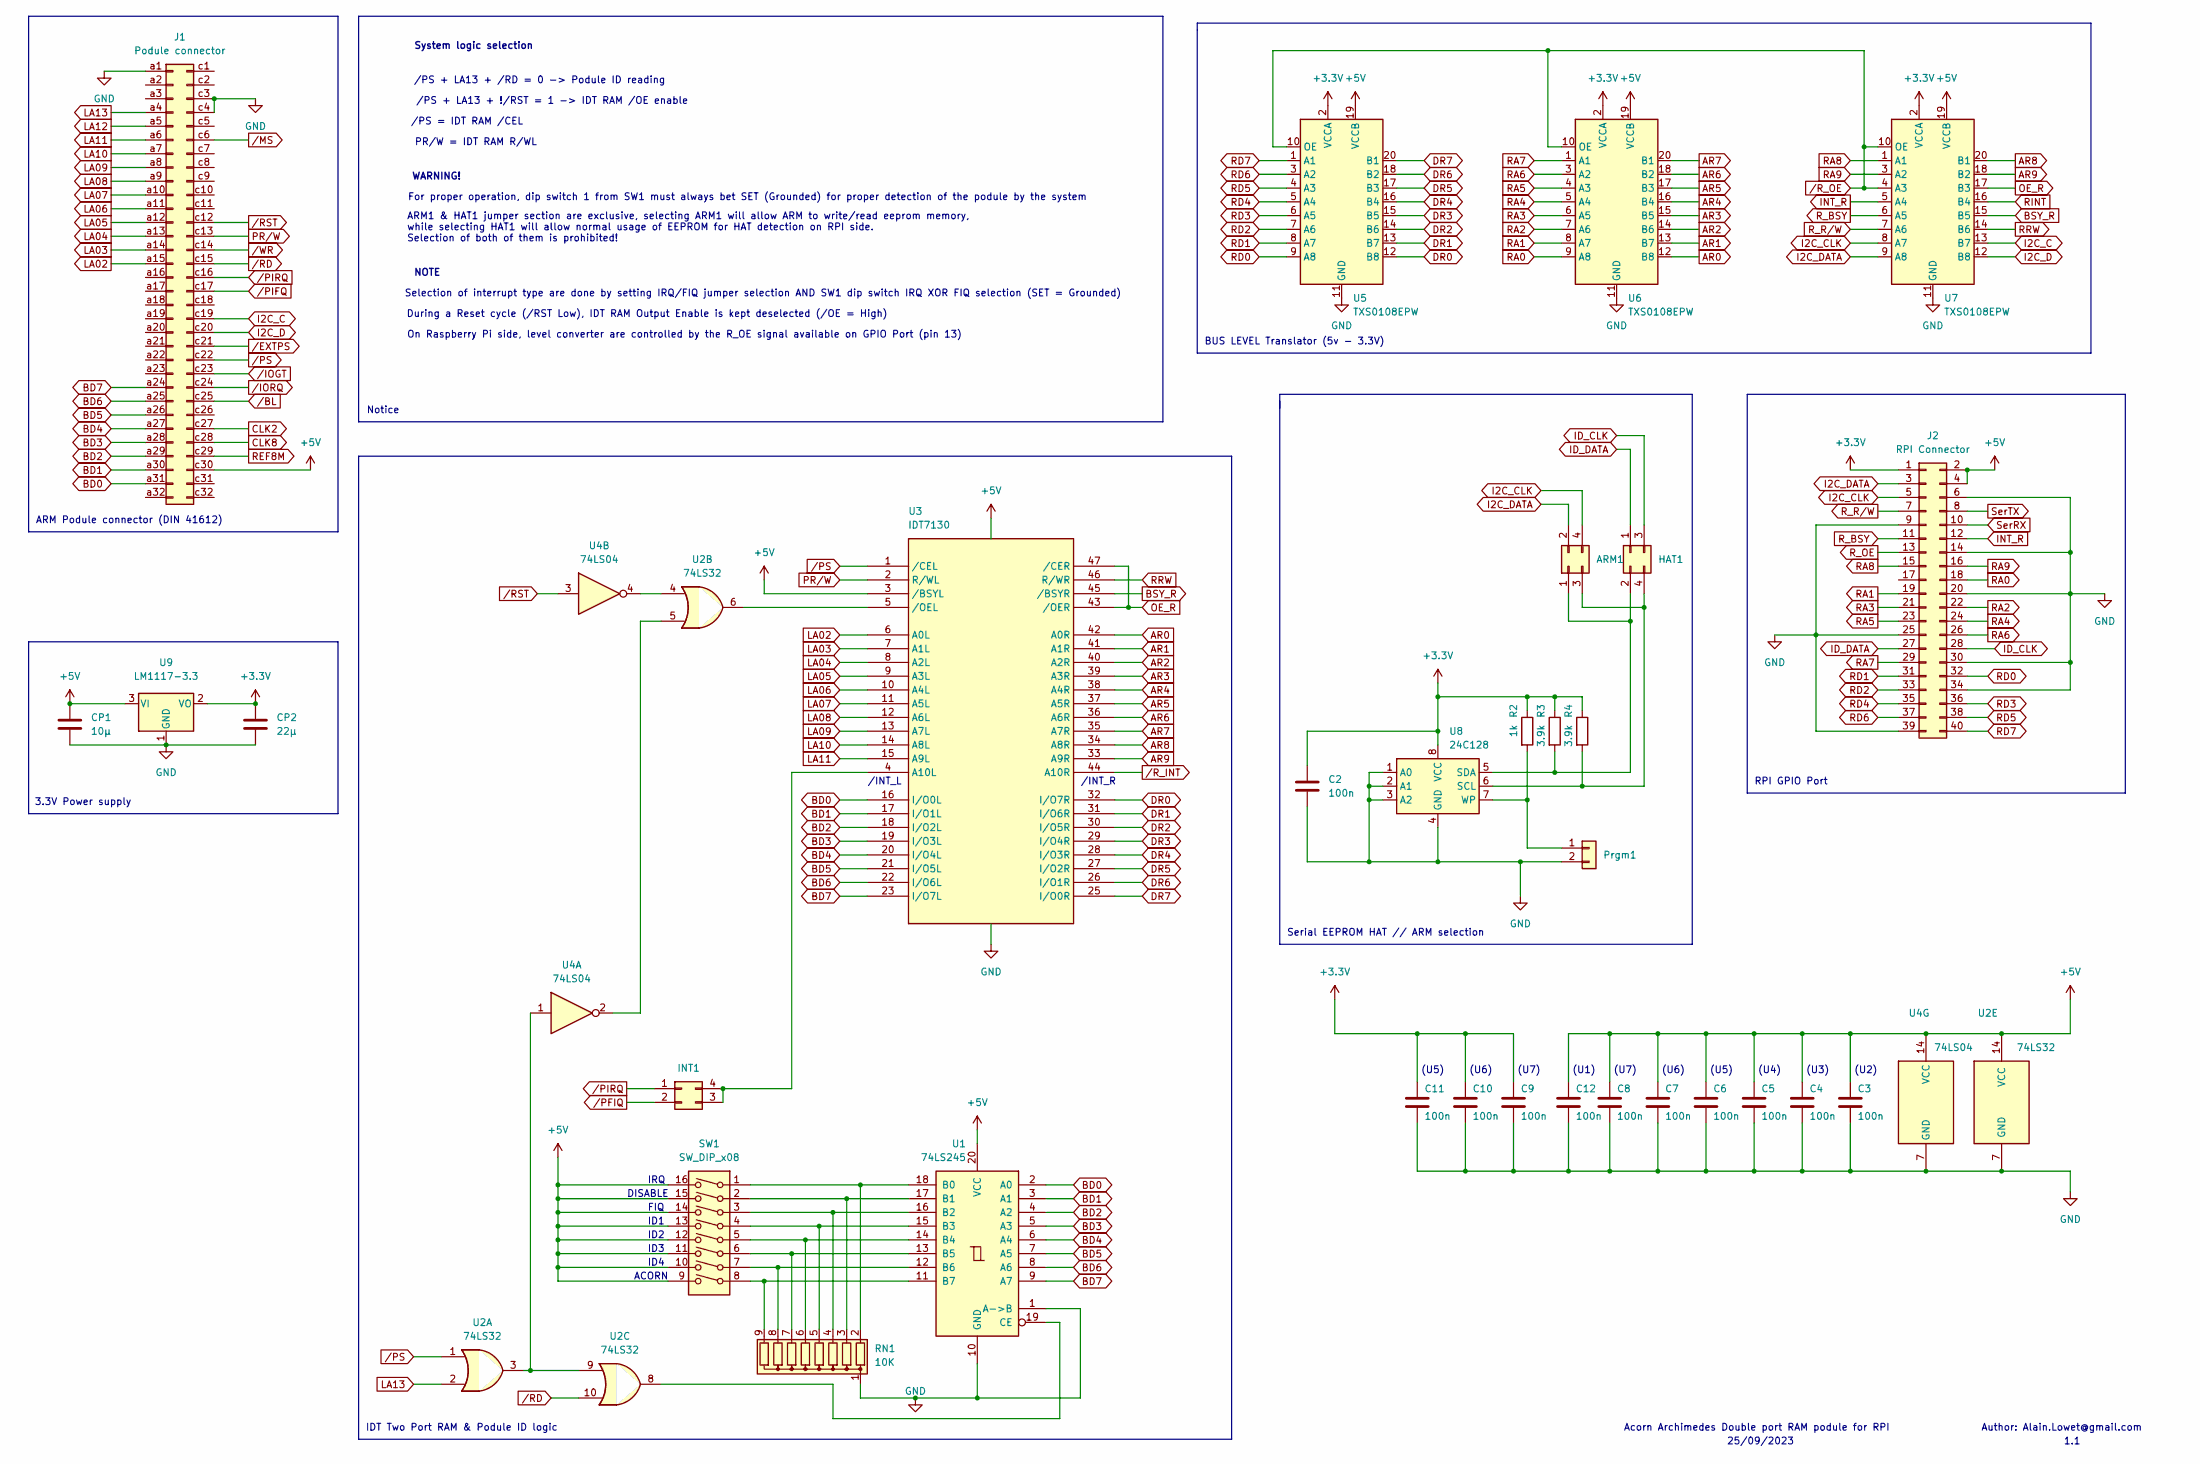
[picture p27: schematic A410_Podule_Ram_RPI.kicad_sch]

Parts:
ARM1: Conn_02x02_Odd_Even; PinHeader_2x02_P2.54mm_Vertical
C2, C3, C4, C5, C6, C7, C8, C9, C10, C11, C12: 100n; C_1210_3225Metric_Pad1.33x2.70mm_HandSolder
CP1: 10µ; CP_Radial_D8.0mm_P5.00mm
CP2: 22µ; CP_Radial_D8.0mm_P5.00mm
HAT1: Conn_02x02_Odd_Even; PinHeader_2x02_P2.54mm_Vertical
INT1: INT; PinHeader_2x02_P2.54mm_Vertical
J1: Podule connector; DIN41612_R_2x32_Male_Horizontal_THT
J2: RPI Connector; PinHeader_2x20_P2.54mm_Vertical
Prgm1: Prgm; PinHeader_1x02_P2.54mm_Vertical
R2: 1k; R_1210_3225Metric_Pad1.30x2.65mm_HandSolder
R3, R4: 3.9k; R_1210_3225Metric_Pad1.30x2.65mm_HandSolder
RN1: 10K; R_Array_SIP9
SW1: SW_DIP_x08; DIP-16_W7.62mm_Socket
U1: 74LS245; DIP-20_W7.62mm_Socket
U2: 74LS32; DIP-14_W7.62mm_Socket
U3: IDT7130; DIP-48_W15.24mm_Socket
U4: 74LS04; DIP-14_W7.62mm_Socket
U5, U6, U7: TXS0108EPW; TSSOP-20_4.4x6.5mm_P0.65mm
U8: 24C128; SOIC-8W_5.3x5.3mm_P1.27mm
U9: LM1117-3.3; SOT-223-3_TabPin2

Connections:
+3.3V: C2.1, C9.1, C10.1, C11.1, CP2.1, J2.1, R2.1, R3.1, R4.1, U5.2 (VCCA), U6.2 (VCCA), U7.2 (VCCA), U8.8 (VCC), U9.2 (VO)
+5V: C3.1, C4.1, C5.1, C6.1, C7.1, C8.1, C12.1, CP1.1, J1.c30, J2.2, J2.4, SW1.9, SW1.10, SW1.11, SW1.12, SW1.13, SW1.14, SW1.15, SW1.16, U1.20 (VCC), U2.14 (VCC), U3.48 (VCC), U4.14 (VCC), U5.19 (VCCB), U6.19 (VCCB), U7.19 (VCCB), U9.3 (VI)
AR0: U3.42 (A0R), U6.12 (B8)
AR1: U3.41 (A1R), U6.13 (B7)
AR2: U3.40 (A2R), U6.14 (B6)
AR3: U3.39 (A3R), U6.15 (B5)
AR4: U3.38 (A4R), U6.16 (B4)
AR5: U3.37 (A5R), U6.17 (B3)
AR6: U3.36 (A6R), U6.18 (B2)
AR7: U3.35 (A7R), U6.20 (B1)
AR8: U3.34 (A8R), U7.20 (B1)
AR9: U3.33 (A9R), U7.18 (B2)
BD0: J1.a31, U1.2 (A0), U3.16 (I/O0L)
BD1: J1.a30, U1.3 (A1), U3.17 (I/O1L)
BD2: J1.a29, U1.4 (A2), U3.18 (I/O2L)
BD3: J1.a28, U1.5 (A3), U3.19 (I/O3L)
BD4: J1.a27, U1.6 (A4), U3.20 (I/O4L)
BD5: J1.a26, U1.7 (A5), U3.21 (I/O5L)
BD6: J1.a25, U1.8 (A6), U3.22 (I/O6L)
BD7: J1.a24, U1.9 (A7), U3.23 (I/O7L)
BSY_R: U3.45 (/BSYR), U7.15 (B5)
CLK2: J1.c27
CLK8: J1.c28
DR0: U3.32 (I/O7R), U5.12 (B8)
DR1: U3.31 (I/O6R), U5.13 (B7)
DR2: U3.30 (I/O5R), U5.14 (B6)
DR3: U3.29 (I/O4R), U5.15 (B5)
DR4: U3.28 (I/O3R), U5.16 (B4)
DR5: U3.27 (I/O2R), U5.17 (B3)
DR6: U3.26 (I/O1R), U5.18 (B2)
DR7: U3.25 (I/O0R), U5.20 (B1)
GND: C2.2, C3.2, C4.2, C5.2, C6.2, C7.2, C8.2, C9.2, C10.2, C11.2, C12.2, CP1.2, CP2.2, J1.a1, J1.c3, J1.c4, J2.6, J2.9, J2.14, J2.20, J2.25, J2.30, J2.34, J2.39, Prgm1.2, RN1.1 (common), U1.1 (A->B), U1.10 (GND), U2.7 (GND), U3.24 (GND), U4.7 (GND), U5.11 (GND), U6.11 (GND), U7.11 (GND), U8.1 (A0), U8.2 (A1), U8.3 (A2), U8.4 (GND), U9.1 (GND)
I2C_C: J1.c19, U7.13 (B7)
I2C_CLK: ARM1.4, J2.5, U7.8 (A7)
I2C_D: J1.c20, U7.12 (B8)
I2C_DATA: ARM1.2, J2.3, U7.9 (A8)
ID_CLK: HAT1.3, J2.28
ID_DATA: HAT1.1, J2.27
INT_R: J2.12, U7.5 (A4)
LA02: J1.a15, U3.6 (A0L)
LA03: J1.a14, U3.7 (A1L)
LA04: J1.a13, U3.8 (A2L)
LA05: J1.a12, U3.9 (A3L)
LA06: J1.a11, U3.10 (A4L)
LA07: J1.a10, U3.11 (A5L)
LA08: J1.a9, U3.12 (A6L)
LA09: J1.a8, U3.13 (A7L)
LA10: J1.a7, U3.14 (A8L)
LA11: J1.a6, U3.15 (A9L)
LA12: J1.a5
LA13: J1.a4, U2.2
unnamed: ARM1.1, HAT1.2, R3.2, U8.5 (SDA)
unnamed: ARM1.3, HAT1.4, R4.2, U8.6 (SCL)
unnamed: INT1.3, INT1.4, U3.4 (A10L)
unnamed: Prgm1.1, R2.2, U8.7 (WP)
unnamed: RN1.2 (R1), SW1.1, U1.18 (B0)
unnamed: RN1.3 (R2), SW1.2, U1.17 (B1)
unnamed: RN1.4 (R3), SW1.3, U1.16 (B2)
unnamed: RN1.5 (R4), SW1.4, U1.15 (B3)
unnamed: RN1.6 (R5), SW1.5, U1.14 (B4)
unnamed: RN1.7 (R6), SW1.6, U1.13 (B5)
unnamed: RN1.8 (R7), SW1.7, U1.12 (B6)
unnamed: RN1.9 (R8), SW1.8, U1.11 (B7)
unnamed: U1.19 (CE), U2.8
unnamed: U2.3, U2.9, U4.1
unnamed: U2.4, U4.4
unnamed: U2.5, U4.2
unnamed: U2.6, U3.5 (/OEL)
OE_R: U3.43 (/OER), U3.47 (/CER), U7.17 (B3)
PR/W: J1.c13, U3.2 (R/WL)
RA0: J2.18, U6.9 (A8)
RA1: J2.19, U6.8 (A7)
RA2: J2.22, U6.7 (A6)
RA3: J2.21, U6.6 (A5)
RA4: J2.24, U6.5 (A4)
RA5: J2.23, U6.4 (A3)
RA6: J2.26, U6.3 (A2)
RA7: J2.29, U6.1 (A1)
RA8: J2.15, U7.1 (A1)
RA9: J2.16, U7.3 (A2)
RD0: J2.32, U5.9 (A8)
RD1: J2.31, U5.8 (A7)
RD2: J2.33, U5.7 (A6)
RD3: J2.36, U5.6 (A5)
RD4: J2.35, U5.5 (A4)
RD5: J2.38, U5.4 (A3)
RD6: J2.37, U5.3 (A2)
RD7: J2.40, U5.1 (A1)
REF8M: J1.c29
RINT: U7.16 (B4)
RRW: U3.46 (R/WR), U7.14 (B6)
R_BSY: J2.11, U7.6 (A5)
R_OE: J2.13
R_R/W: J2.7, U7.7 (A6)
SerRX: J2.10
SerTX: J2.8
/BL: J1.c25
/EXTPS: J1.c21
/IOGT: J1.c23
/IORQ: J1.c24
/MS: J1.c6
/PFIQ: INT1.2
/PIFQ: J1.c17
/PIRQ: INT1.1, J1.c16
/PS: J1.c22, U2.1, U3.1 (/CEL)
/RD: J1.c15, U2.10
/RST: J1.c12, U4.3
/R_INT: U3.44 (A10R)
/R_OE: U5.10 (OE), U6.10 (OE), U7.4 (A3), U7.10 (OE)
/WR: J1.c14

Notes on the sheet:
(U5)
RPI GPIO Port
For proper operation, dip switch 1 from SW1 must always bet SET (Grounded) for proper detection of the podule by the system
(U4)
ARM Podule connector (DIN 41612)
System logic selection
ID3
NOTE
(U2)
(U7)
ARM1 & HAT1 jumper section are exclusive, selecting ARM1 will allow ARM to write/read eeprom memory, while selecting HAT1 will allow normal usage of EEPROM for HAT detection on RPI side. Selection of both of them is prohibited!
ID2
(U3)
Acorn Archimedes Double port RAM podule for RPI
Notice
WARNING!
On Raspberry Pi side, level converter are controlled by the R_OE signal available on GPIO Port (pin 13)
(U1)
3.3V Power supply
Serial EEPROM HAT // ARM selection
1.1
Selection of interrupt type are done by setting IRQ/FIQ jumper selection AND SW1 dip switch IRQ XOR FIQ selection (SET = Grounded)
FIQ
/INT_R
ID4
/PS + LA13 + !/RST = 1 -> IDT RAM /OE enable
(U6)
BUS LEVEL Translator (5v - 3.3V)
/INT_L
IDT Two Port RAM & Podule ID logic
/PS + LA13 + /RD = 0 -> Podule ID reading
Author: Alain.Lowet@gmail.com
ID1
25/09/2023
IRQ
DISABLE
PR/W = IDT RAM R/WL
ACORN
/PS = IDT RAM /CEL
During a Reset cycle (/RST Low), IDT RAM Output Enable is kept deselected (/OE = High)

Board: 2 copper layers, 33 parts (0 on the bottom side), 93 nets, no tracks yet.
