alow2004/Archimedes_RPI_DoublePort_RAM_Podule/(commit log)

2023-09-29 Add files via upload
    PCB pictures top&bottom
2023-09-30 Add files via upload
    Added Kicad files...
    [A410_Podule_Ram_RPI-B_Cu.gbr, A410_Podule_Ram_RPI-B_Mask.gbr, A410_Podule_Ram_RPI-B_Paste.gbr, A410_Podule_Ram_RPI-B_Silkscreen.gbr, A410_Podule_Ram_RPI-Edge_Cuts.gbr, A410_Podule_Ram_RPI-F_Cu.gbr, A410_Podule_Ram_RPI-F_Mask.gbr, A410_Podule_Ram_RPI-F_Paste.gbr]
2023-10-10 Add files via upload
    Some pictures of the received prototype boards
2023-10-23 New IDT 7134 4K * 8 bits double port ram version
    Extend the memory available at maximum permitted podule space
    [A410_Bridge_7134.csv, A410_Bridge_7134.kicad_pcb, A410_Bridge_7134.kicad_sch]
2023-10-25 some picture of rev 1.0 board
2023-10-30 IDT 7134 version, board pictures
2023-10-31 pictures of mounted cards
