alow2004/Archimedes_RPI_DoublePort_RAM_Podule/(notices)

Notices in the files:
A410_Podule_Ram_RPI/A410_Podule_Ram_RPI.kicad_pcb:
© 2023 - Elitech - ALO
